janelia-modular-devices/user_interface/README.org

#+TITLE: user_interface
#+AUTHOR: Peter Polidoro
#+EMAIL: peter@polidoro.io

* Repository Information
  - Author :: Peter Polidoro
  - License :: BSD
