janelia-modular-devices/user_interface/hardware/teensy/bom/bom_pcb_add.csv

Item | Function | Quantity | Description | PartNumber | Vendor
1 | CONNECTORS | 1 | 11 Position Header Connector 0.100in | S7044-ND | digikey
1 | SPACERS | 4 | Hex Standoff Threaded 4-40 Aluminum 7/16in | 36-NC121034A-ND | digikey
