janelia-modular-devices/user_interface/hardware/teensy/schematic/user_interface_teensy.pdf

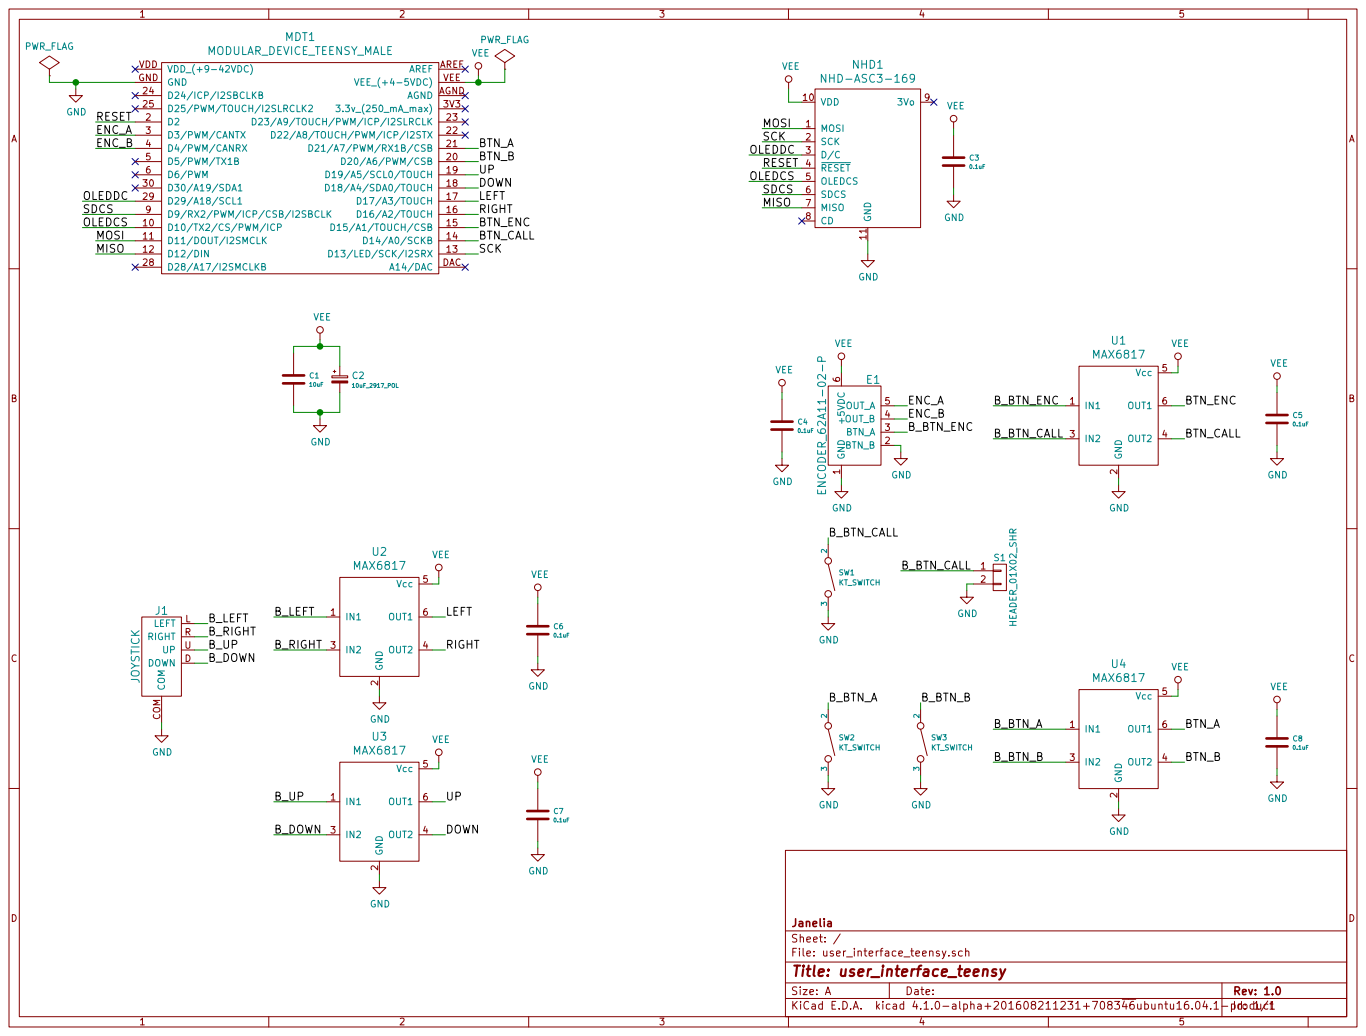
[picture p1: page 1]

File: user_interface_teensy.sch Sheet: / Janelia
