janelia-modular-devices/user_interface/(list of files, drawings)

Other design files:
hardware/teensy/user_interface_teensy.dsn
