janelia-modular-devices/user_interface/hardware/teensy/user_interface_teensy.kicad_pcb

## KiCad design hardware/teensy/user_interface_teensy.kicad_pcb (2016-08-26)

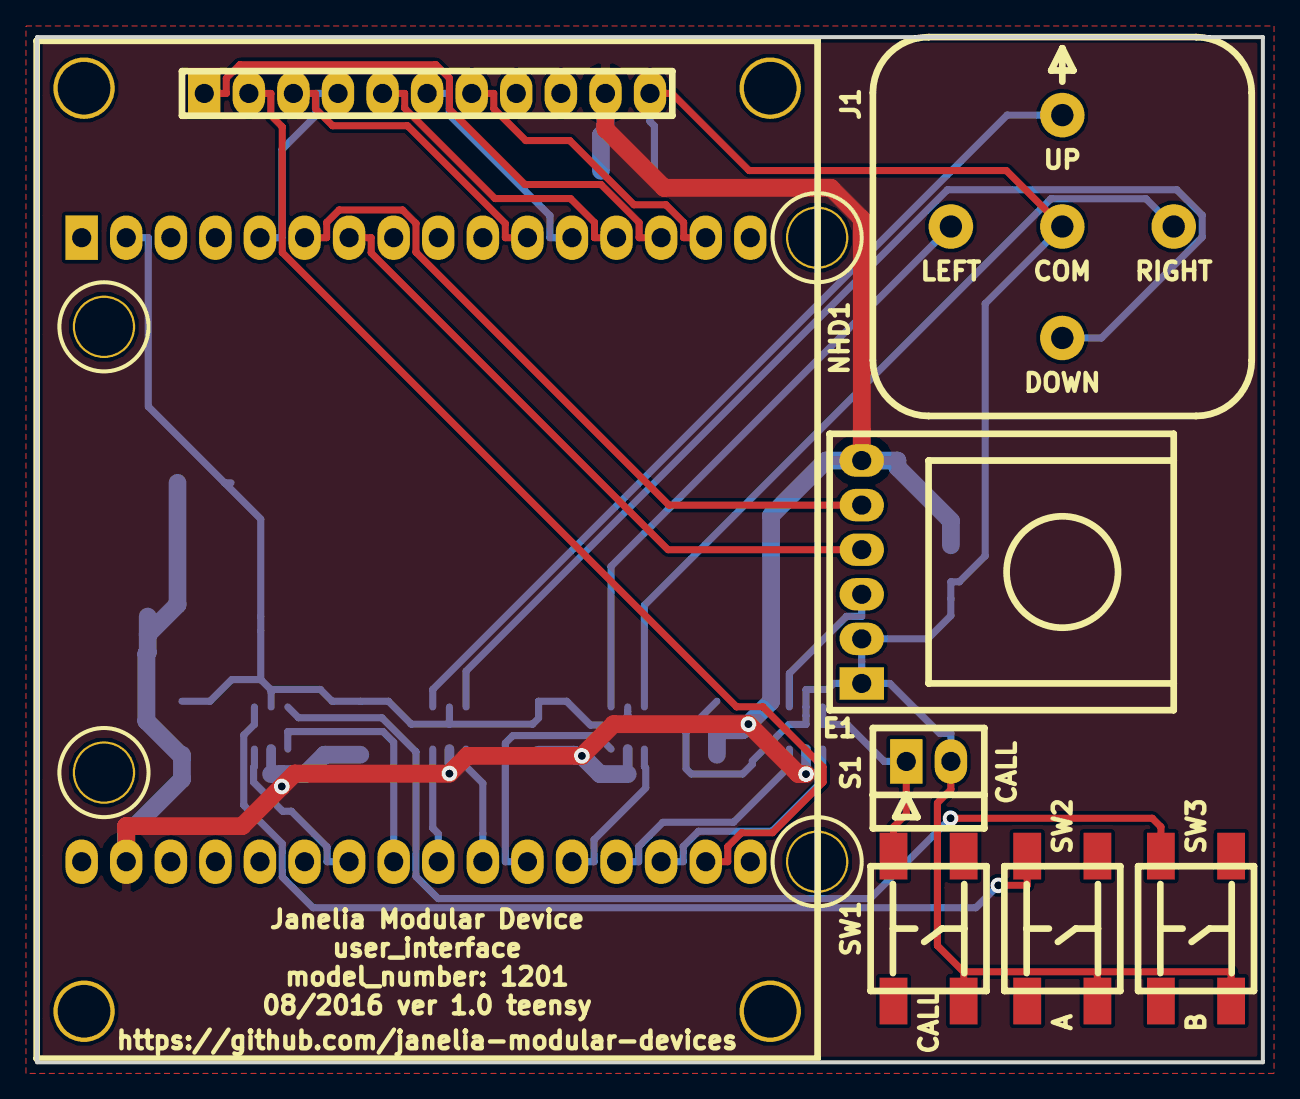
[picture p2: board user_interface_teensy.kicad_pcb from above]

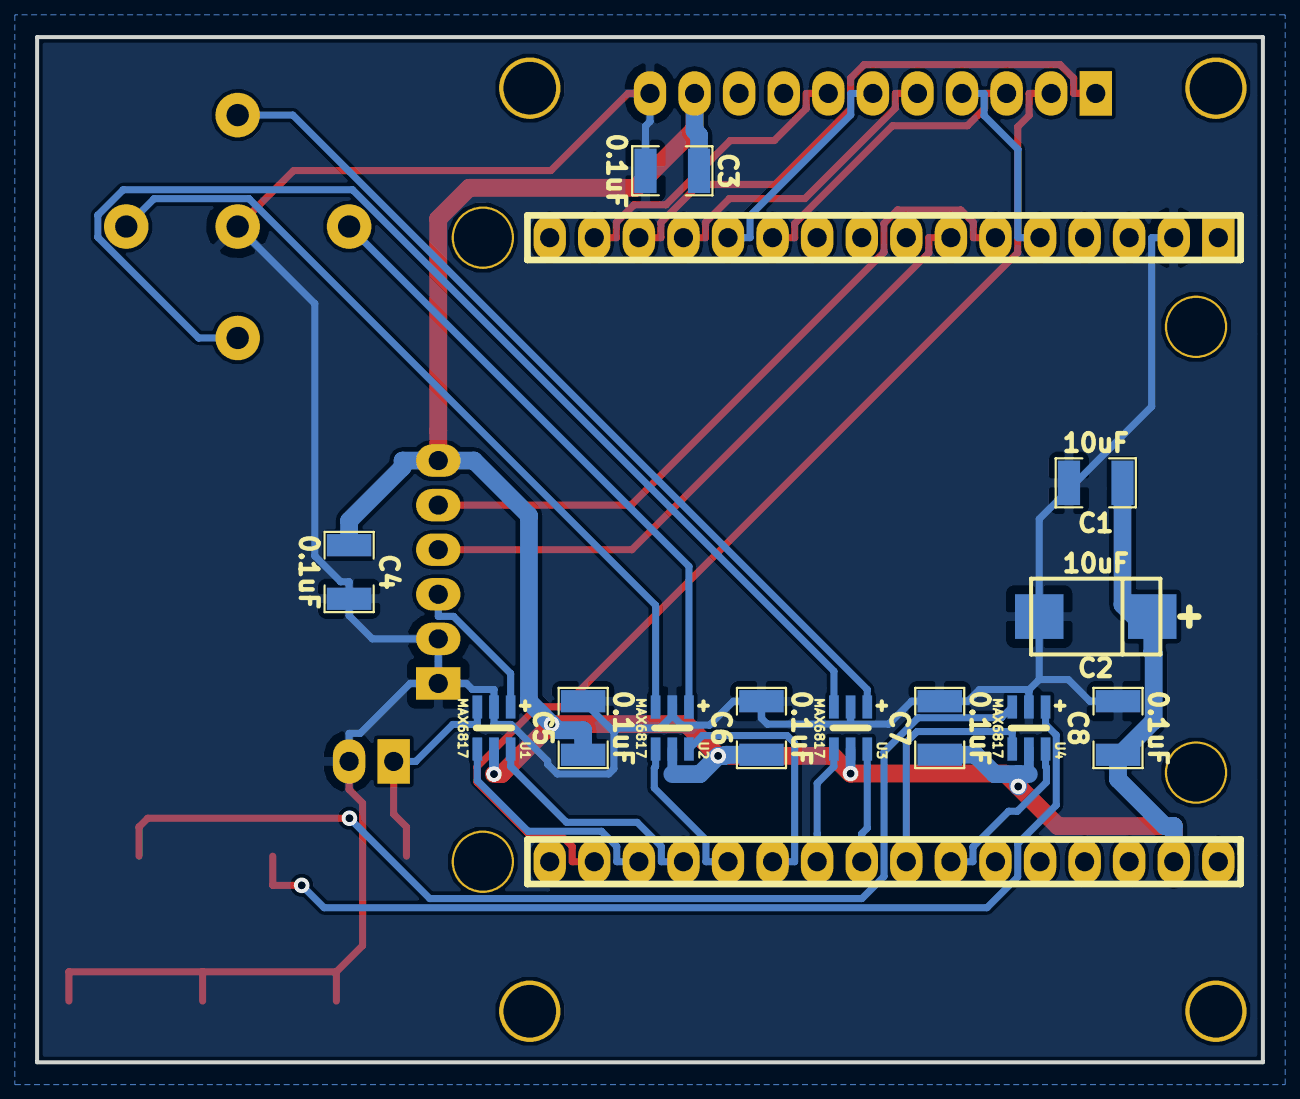
[picture p3: board user_interface_teensy.kicad_pcb from below]

Board: 2 copper layers, 69.8 x 58.4 mm, 20 parts (12 on the bottom side), 27 nets.

Parts:
C1: 10uF; SM1210
C2: 10uF; SM2917_POL
C3, C4, C5, C6, C7, C8: 0.1uF; SM1210
E1: ENCODER_62A11-02-P; ENCODER_62AVD
J1: JOYSTICK
MDT1: MODULAR_DEVICE_TEENSY_MALE
NHD1: NHD-ASC3-169; NHD-ASC3
S1: HEADER_01X02_SHR; Header_Shrouded_2_Pin
SW1, SW2, SW3: KT_SWITCH
U1, U2, U3, U4: MAX6817

Connections:
/BTN_A: MDT1.21, U4.6
/BTN_B: MDT1.20, U4.4
/BTN_CALL: MDT1.14, U1.4
/BTN_ENC: MDT1.15, U1.6
/B_BTN_A: SW2.2, U4.1
/B_BTN_B: SW3.2, U4.3
/B_BTN_CALL: S1.1, SW1.2, U1.3
/B_BTN_ENC: E1.3, U1.1
/B_DOWN: J1.D, U3.3
/B_LEFT: J1.L, U2.1
/B_RIGHT: J1.R, U2.3
/B_UP: J1.U, U3.1
/DOWN: MDT1.18, U3.4
/ENC_A: E1.5, MDT1.3
/ENC_B: E1.4, MDT1.4
/LEFT: MDT1.17, U2.6
/MISO: MDT1.12, NHD1.7
/MOSI: MDT1.11, NHD1.1
/OLEDCS: MDT1.10, NHD1.5
/OLEDDC: MDT1.29, NHD1.3
/RESET: MDT1.2, NHD1.4
/RIGHT: MDT1.16, U2.4
/SCK: MDT1.13, NHD1.2
/SDCS: MDT1.9, NHD1.6
/UP: MDT1.19, U3.6
GND: C1.2, C2.2, C3.2, C4.2, C5.2, C6.2, C7.2, C8.2, E1.1, E1.2, J1.COM, MDT1.GND, NHD1.11, S1.2, SW1.3, SW2.3, SW3.3, U1.2, U2.2, U3.2, U4.2
VEE: C1.1, C2.1, C3.1, C4.1, C5.1, C6.1, C7.1, C8.1, E1.6, MDT1.VEE, NHD1.10, U1.5, U2.5, U3.5, U4.5
