janelia-modular-devices/user_interface/(commit log)

2016-07-26 Initial commit.
    [user_interface_teensy.dsn, user_interface_teensy.kicad_pcb, user_interface_teensy.sch]
2016-07-26 Progress towards schematic v1.0.
    [user_interface_teensy.kicad_pcb, user_interface_teensy.sch]
2016-07-27 Added encoder.
2016-08-25 Progress towards teensy v1.0.
    [user_interface_teensy.sch]
2016-08-26 Finished pcb v1.0.
    [bom_pcb.csv, bom_pcb_add.csv, digikey_order.csv, digikey_order_pcb.csv, digikey_order_pcb_add.csv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]
2016-09-21 pcb -> hardware.
    [bom_pcb.csv, bom_pcb_add.csv, digikey_order.csv, digikey_order_pcb.csv, digikey_order_pcb_add.csv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]
